robotarium/GRITSBotX_hardware_design/chassisDesign/GritsbotX_1_8.pdf

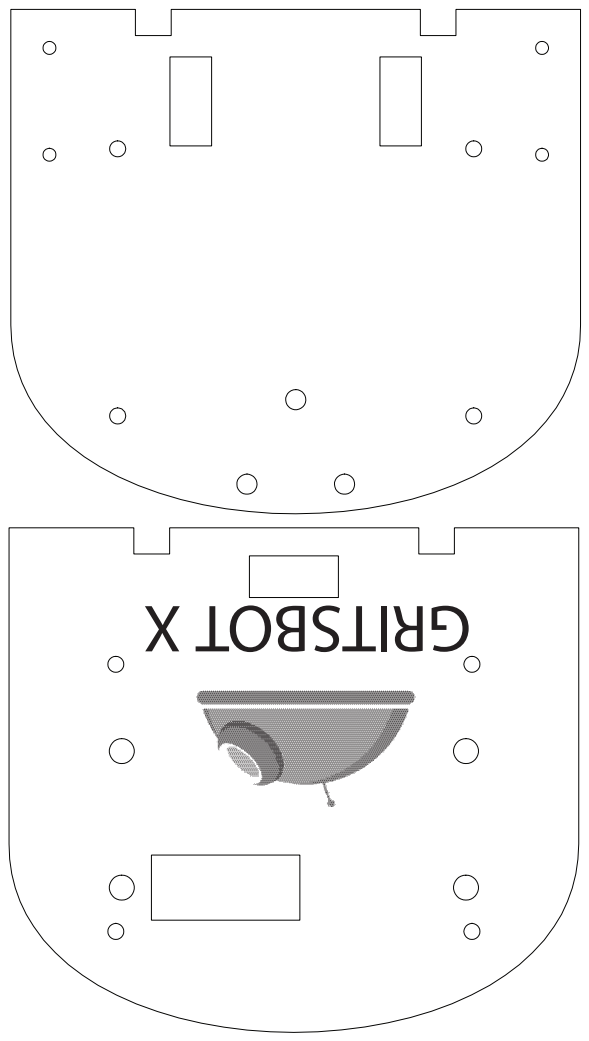
[picture p1: page 1]
GRITSBOT X
