robotarium/GRITSBotX_hardware_design/circuitBoard/GRITSBotX_Full/mainBoard.brd

## EAGLE design circuitBoard/GRITSBotX_Full/mainBoard.brd (2020-12-18)

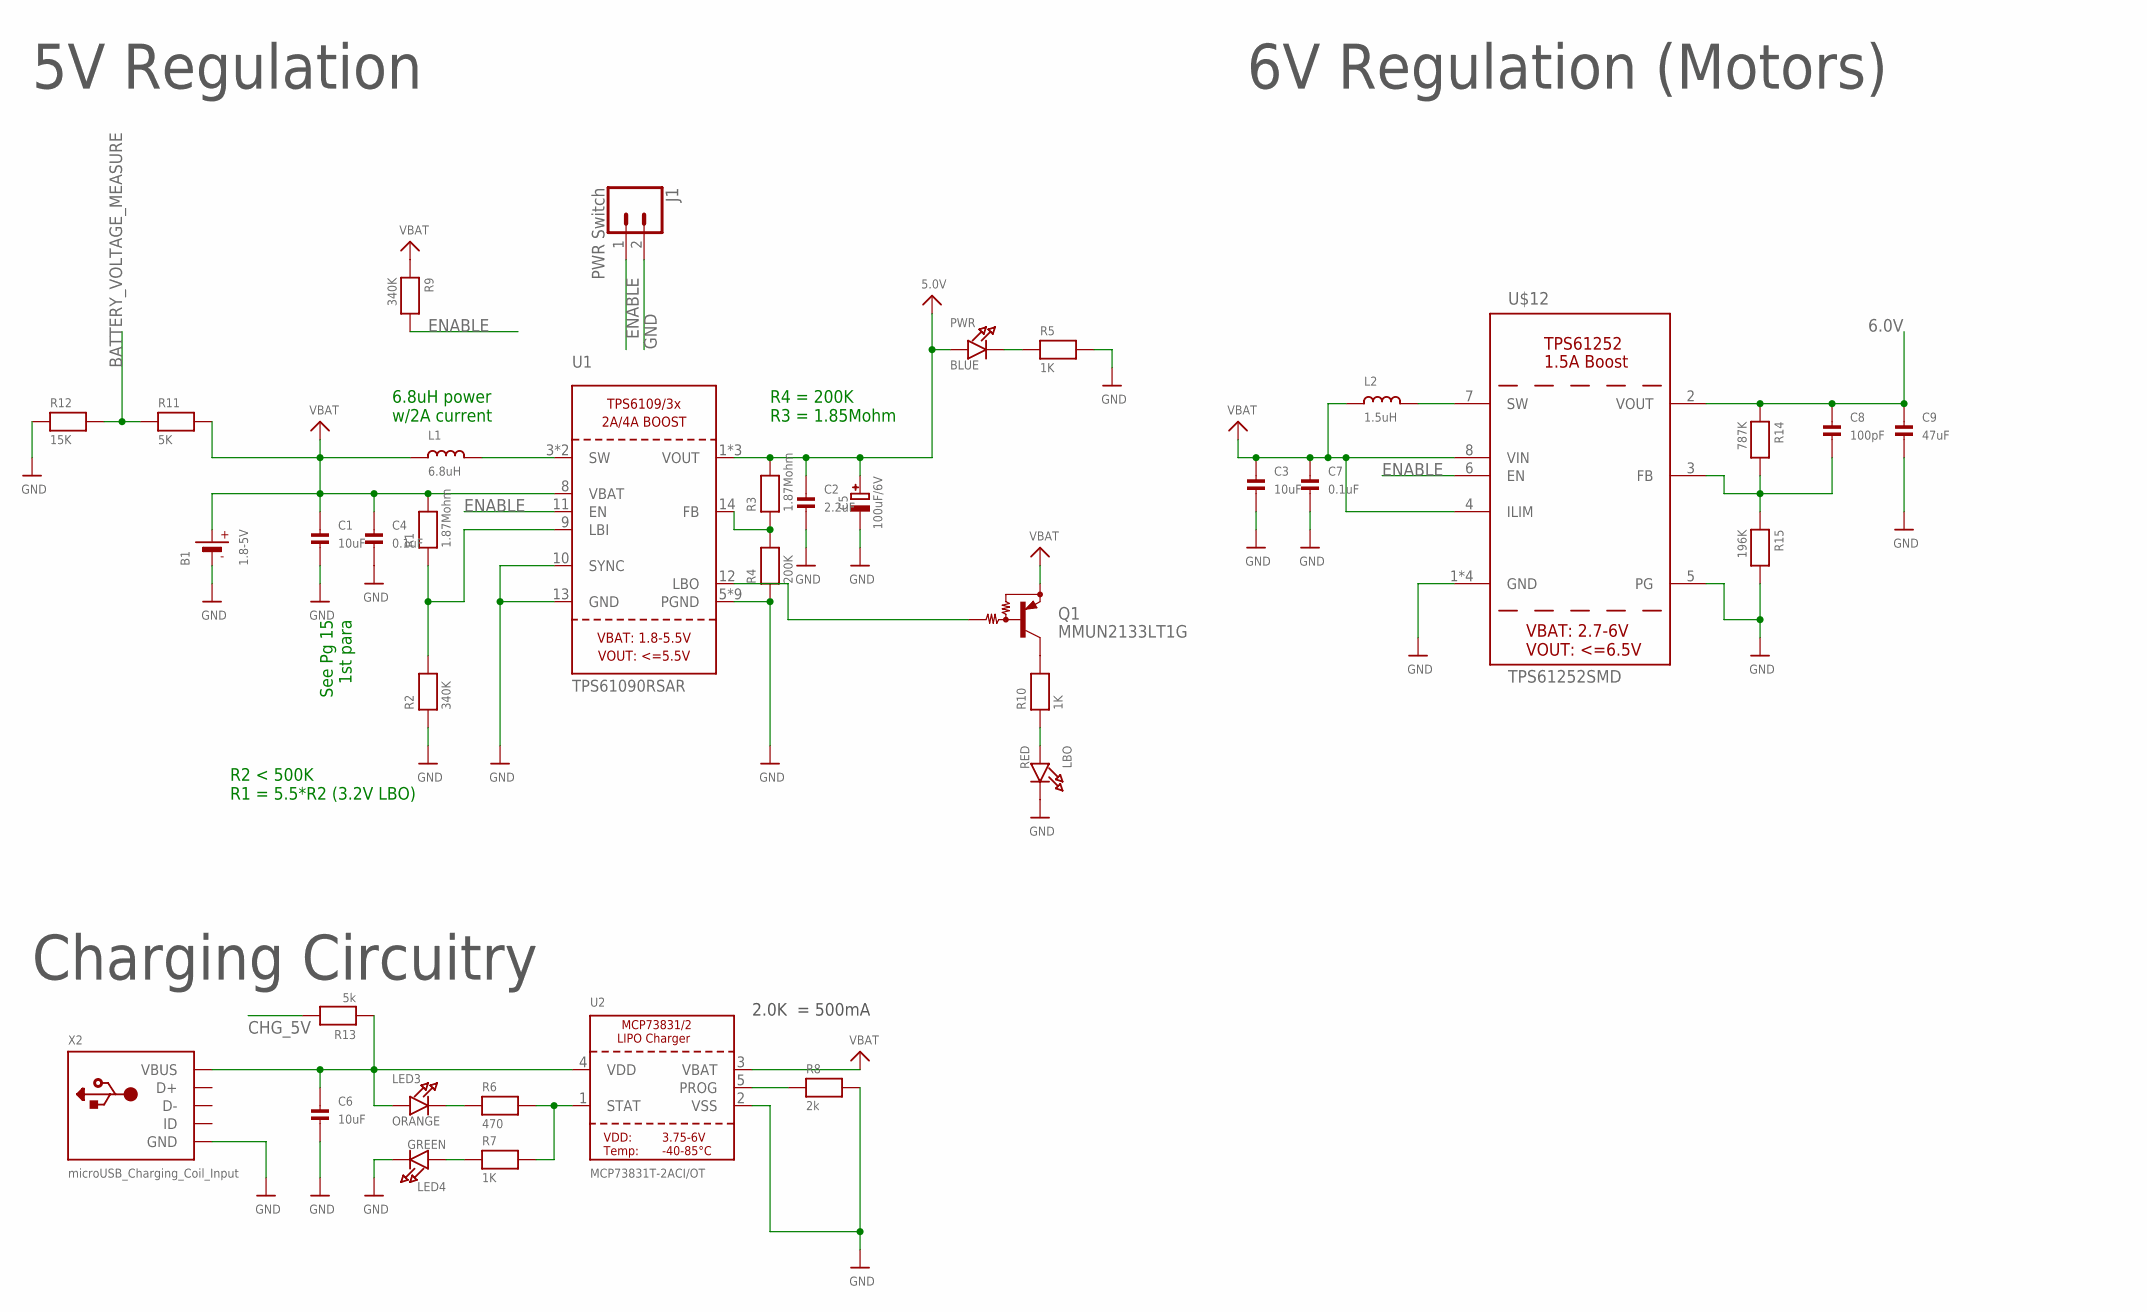
[picture p2: schematic mainBoard.sch, sheet 1]

Parts:
B1: 1.8-5V; JSTPH2
C1, C3, C6: 10uF; 0603
C2: 2.2uF; 0603
C4, C7: 0.1uF; 0805
C5: 100uF/6V; EIA3528-21/B-R
C8: 100pF; 0603
C9: 47uF; 1206
J1: PWR Switch; 1X02
L1: 6.8uH; VISHAY_IHLP2525CZER6R8M01
L2: 1.5uH; MURATA_DFE252012P-1R5M=P2
LBO: RED; CHIPLED_0805_NOOUTLINE
LED3: ORANGE; CHIPLED_0805_NOOUTLINE
LED4: GREEN; CHIPLED_0805_NOOUTLINE
PWR: BLUE; CHIPLED_0805_NOOUTLINE
Q1: MMUN2133LT1G; SC59-BEC
R1, R3: 1.87Mohm; 0805
R2, R9: 340K; 0805
R4: 200K; 0805
R5, R7, R10: 1K; 0805
R6: 470; 0805
R8: 2k; 0805
R11: 5K; 0805
R12: 15K; 0805
R13: 5k; 0805
R14: 787K; 0805
R15: 196K; 0805
U1: TPS61090RSAR; PVQFN-16
U2: MCP73831T-2ACI/OT; SOT23-5
U$12: TPS61252SMD; TPS61252
X2: microUSB_Charging_Coil_Input; 4UCONN_20329

Connections:
5.0V: C2.1, C5.+, PWR.A, R3.2, U1.1 (VOUT), U1.15 (VOUT), U1.16 (VOUT); also elsewhere on the board
6.0V: C8.1, C9.1, R14.1, U$12.2 (VOUT); also elsewhere on the board
BATTERY_VOLTAGE_MEASURE: R11.1, R12.2; also elsewhere on the board
CHARGING_BOOL_5V: C6.1, LED3.A, R13.1, U2.4 (VDD), X2.VBUS
CHG_5V: R13.2; also elsewhere on the board
ENABLE: J1.1, R9.2, U1.11 (EN), U$12.6 (EN)
GND: B1.1 (-), C1.2, C2.2, C3.2, C4.2, C5.-, C6.2, C7.2, C9.2, J1.2, LBO.C, LED4.C, R2.1, R4.1, R5.2, R8.2, R12.1, R15.2, U1.5 (PGND), U1.6 (PGND), U1.7 (PGND), U1.10 (SYNC), U1.13 (GND), U1.P$18 (PGND), U1.P$19 (PGND), U1.P$20 (PGND), U1.P$21 (PGND), U1.P$22 (PGND), U1.THERMAL (PGND), U2.2 (VSS), U$12.1 (GND), U$12.5 (PG), U$12.P$2_GND (GND), U$12.P$3_GND (GND), U$12.THERMAL_GND (GND), X2.BASE@1 (GND), X2.BASE@2 (GND), X2.GND, X2.SPRT@1 (GND), X2.SPRT@2 (GND), X2.SPRT@3 (GND), X2.SPRT@4 (GND); also elsewhere on the board
LBO: Q1.B, U1.12 (LBO)
unnamed: L1.P$2 (2), U1.3 (SW), U1.4 (SW)
unnamed: LBO.A, R10.1
unnamed: R1.1, R2.2, U1.9 (LBI)
unnamed: PWR.C, R5.1
unnamed: R3.1, R4.2, U1.14 (FB)
unnamed: LED3.C, R6.1
unnamed: R6.2, R7.2, U2.1 (STAT)
unnamed: R8.1, U2.5 (PROG)
unnamed: LED4.A, R7.1
unnamed: Q1.C, R10.2
unnamed: L2.P$2 (2), U$12.7 (SW)
unnamed: C8.2, R14.2, R15.1, U$12.3 (FB)
VBAT: B1.2 (+), C1.1, C3.1, C4.1, C7.1, L1.P$1 (1), L2.P$1 (1), Q1.E, R1.2, R9.1, R11.2, U1.8 (VBAT), U2.3 (VBAT), U$12.4 (ILIM), U$12.8 (VIN)

Notes on the sheet:
See Pg 15 1st para
6.8uH power w/2A current
R2 < 500K R1 = 5.5*R2 (3.2V LBO)
R4 = 200K R3 = 1.85Mohm
2.0K = 500mA
Charging Circuitry
5V Regulation
6V Regulation (Motors)

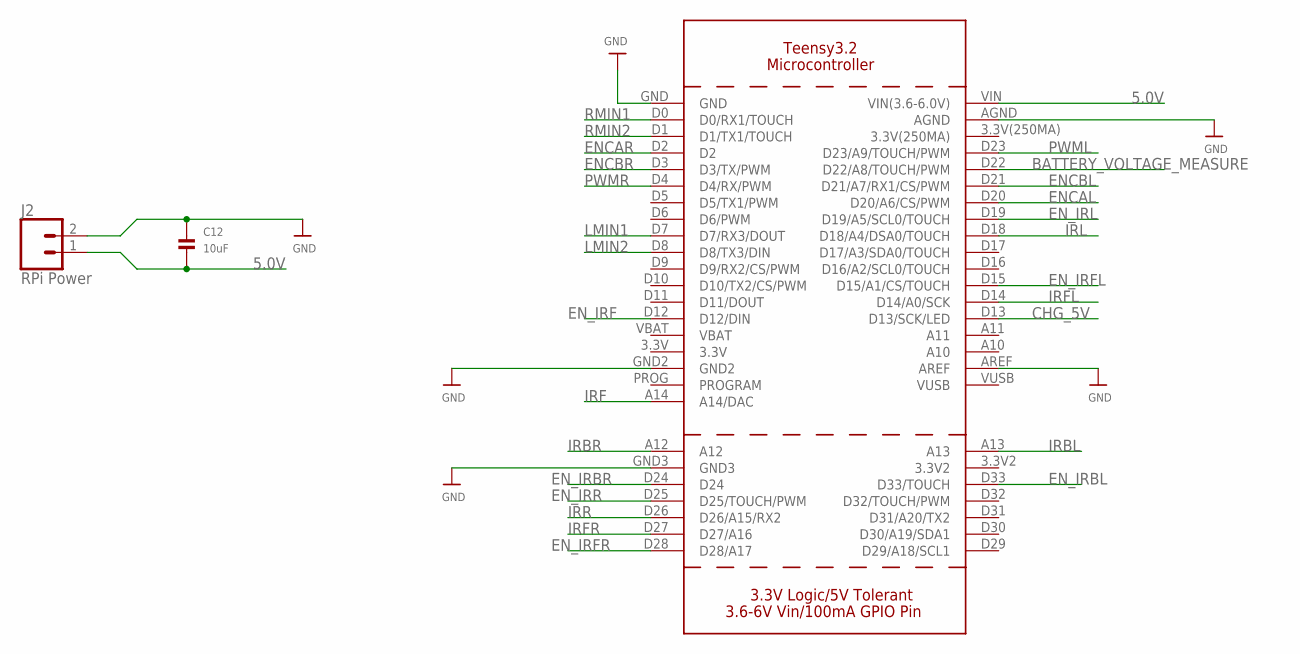
[picture p3: schematic mainBoard.sch, sheet 2]

Parts:
C12: 10uF; 0603
J2: RPi Power; 1X02
U$28: TEENSY3_2

Connections:
5.0V: C12.2, J2.1, U$28.VIN (VIN(3.6-6.0V)); also elsewhere on the board
BATTERY_VOLTAGE_MEASURE: U$28.D22 (D22/A8/TOUCH/PWM); also elsewhere on the board
CHG_5V: U$28.D13 (D13/SCK/LED); also elsewhere on the board
ENCAL: U$28.D20 (D20/A6/CS/PWM); also elsewhere on the board
ENCAR: U$28.D2; also elsewhere on the board
ENCBL: U$28.D21 (D21/A7/RX1/CS/PWM); also elsewhere on the board
ENCBR: U$28.D3 (D3/TX/PWM); also elsewhere on the board
EN_IRBL: U$28.D33 (D33/TOUCH); also elsewhere on the board
EN_IRBR: U$28.D24; also elsewhere on the board
EN_IRF: U$28.D12 (D12/DIN); also elsewhere on the board
EN_IRFL: U$28.D15 (D15/A1/CS/TOUCH); also elsewhere on the board
EN_IRFR: U$28.D28 (D28/A17); also elsewhere on the board
EN_IRL: U$28.D19 (D19/A5/SCL0/TOUCH); also elsewhere on the board
EN_IRR: U$28.D25 (D25/TOUCH/PWM); also elsewhere on the board
GND: C12.1, J2.2, U$28.AGND, U$28.AREF, U$28.GND, U$28.GND2, U$28.GND3; also elsewhere on the board
IRBL: U$28.A13; also elsewhere on the board
IRBR: U$28.A12; also elsewhere on the board
IRF: U$28.A14 (A14/DAC); also elsewhere on the board
IRFL: U$28.D14 (D14/A0/SCK); also elsewhere on the board
IRFR: U$28.D27 (D27/A16); also elsewhere on the board
IRL: U$28.D18 (D18/A4/DSA0/TOUCH); also elsewhere on the board
IRR: U$28.D26 (D26/A15/RX2); also elsewhere on the board
LMIN1: U$28.D7 (D7/RX3/DOUT); also elsewhere on the board
LMIN2: U$28.D8 (D8/TX3/DIN); also elsewhere on the board
PWML: U$28.D23 (D23/A9/TOUCH/PWM); also elsewhere on the board
PWMR: U$28.D4 (D4/RX/PWM); also elsewhere on the board
RMIN1: U$28.D0 (D0/RX1/TOUCH); also elsewhere on the board
RMIN2: U$28.D1 (D1/TX1/TOUCH); also elsewhere on the board

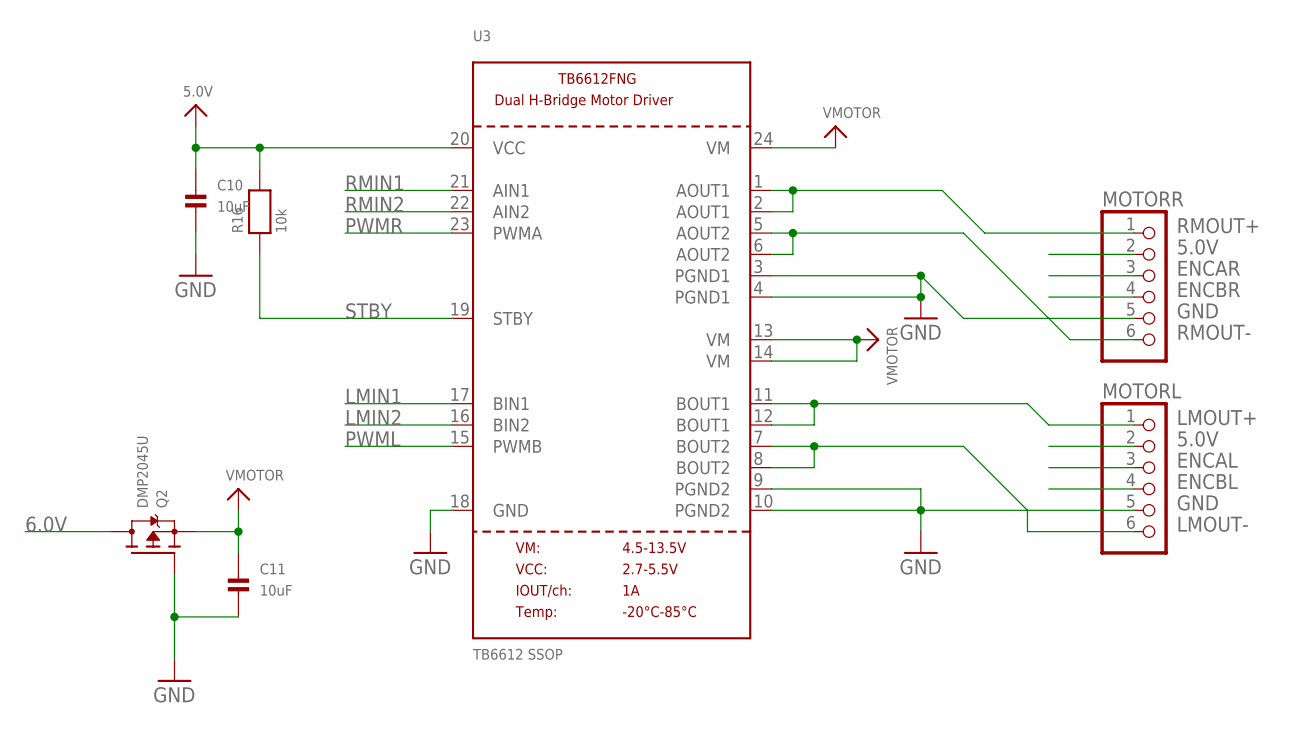
[picture p4: schematic mainBoard.sch, sheet 3]

Parts:
C10, C11: 10uF; 0603
MOTORL: PINHD-1X6CB; 1X06-CLEANBIG
MOTORR: PINHD-1X6CB; 1X06-CLEANBIG
Q2: DMP2045U; SOT23-WIDE
R16: 10k; 0805
U3: TB6612 SSOP; SSOP24

Connections:
5.0V: C10.1, MOTORL.2, MOTORR.2, R16.2, U3.20 (VCC); also elsewhere on the board
6.0V: Q2.3 (D); also elsewhere on the board
ENCAL: MOTORL.3; also elsewhere on the board
ENCAR: MOTORR.3; also elsewhere on the board
ENCBL: MOTORL.4; also elsewhere on the board
ENCBR: MOTORR.4; also elsewhere on the board
GND: C10.2, C11.2, MOTORL.5, MOTORR.5, Q2.1 (G), U3.3 (PGND1), U3.4 (PGND1), U3.9 (PGND2), U3.10 (PGND2), U3.18 (GND); also elsewhere on the board
LMIN1: U3.17 (BIN1); also elsewhere on the board
LMIN2: U3.16 (BIN2); also elsewhere on the board
LMOUT+: MOTORL.1, U3.11 (BOUT1), U3.12 (BOUT1)
LMOUT-: MOTORL.6, U3.7 (BOUT2), U3.8 (BOUT2)
PWML: U3.15 (PWMB); also elsewhere on the board
PWMR: U3.23 (PWMA); also elsewhere on the board
RMIN1: U3.21 (AIN1); also elsewhere on the board
RMIN2: U3.22 (AIN2); also elsewhere on the board
RMOUT+: MOTORR.1, U3.1 (AOUT1), U3.2 (AOUT1)
RMOUT-: MOTORR.6, U3.5 (AOUT2), U3.6 (AOUT2)
STBY: R16.1, U3.19 (STBY)
VMOTOR: C11.1, Q2.2 (S), U3.13 (VM), U3.14 (VM), U3.24 (VM)

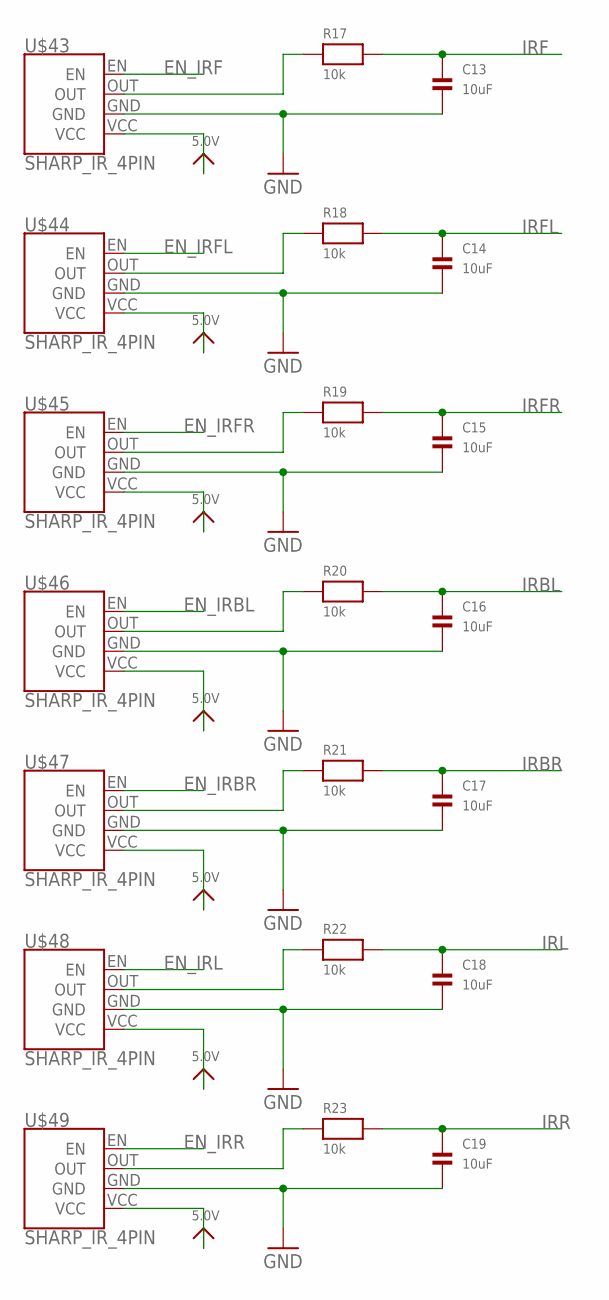
[picture p5: schematic mainBoard.sch, sheet 4]

Parts:
C13, C14, C15, C16, C17, C18, C19: 10uF; 0603
R17, R18, R19, R20, R21, R22, R23: 10k; 0805
U$43, U$44, U$45, U$46, U$47, U$48, U$49: SHARP_IR_4PIN

Connections:
5.0V: U$43.VCC, U$44.VCC, U$45.VCC, U$46.VCC, U$47.VCC, U$48.VCC, U$49.VCC; also elsewhere on the board
EN_IRBL: U$46.EN; also elsewhere on the board
EN_IRBR: U$47.EN; also elsewhere on the board
EN_IRF: U$43.EN; also elsewhere on the board
EN_IRFL: U$44.EN; also elsewhere on the board
EN_IRFR: U$45.EN; also elsewhere on the board
EN_IRL: U$48.EN; also elsewhere on the board
EN_IRR: U$49.EN; also elsewhere on the board
GND: C13.2, C14.2, C15.2, C16.2, C17.2, C18.2, C19.2, U$43.GND, U$44.GND, U$45.GND, U$46.GND, U$47.GND, U$48.GND, U$49.GND; also elsewhere on the board
IRBL: C16.1, R20.2; also elsewhere on the board
IRBR: C17.1, R21.2; also elsewhere on the board
IRF: C13.1, R17.2; also elsewhere on the board
IRFL: C14.1, R18.2; also elsewhere on the board
IRFR: C15.1, R19.2; also elsewhere on the board
IRL: C18.1, R22.2; also elsewhere on the board
IRR: C19.1, R23.2; also elsewhere on the board
unnamed: R23.1, U$49.OUT
unnamed: R22.1, U$48.OUT
unnamed: R21.1, U$47.OUT
unnamed: R20.1, U$46.OUT
unnamed: R19.1, U$45.OUT
unnamed: R18.1, U$44.OUT
unnamed: R17.1, U$43.OUT

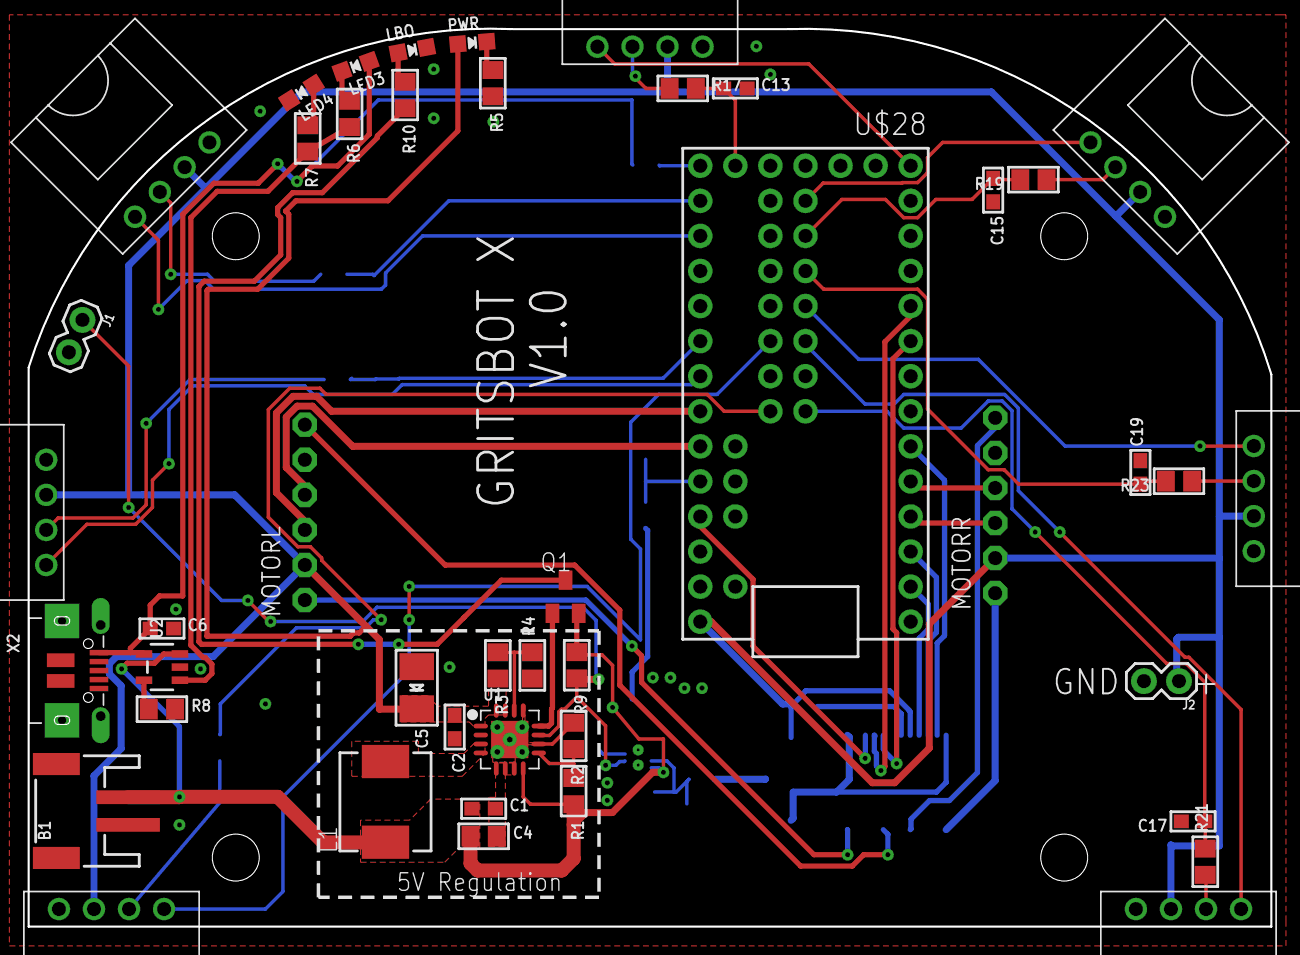
[picture p6: board mainBoard.brd from above]

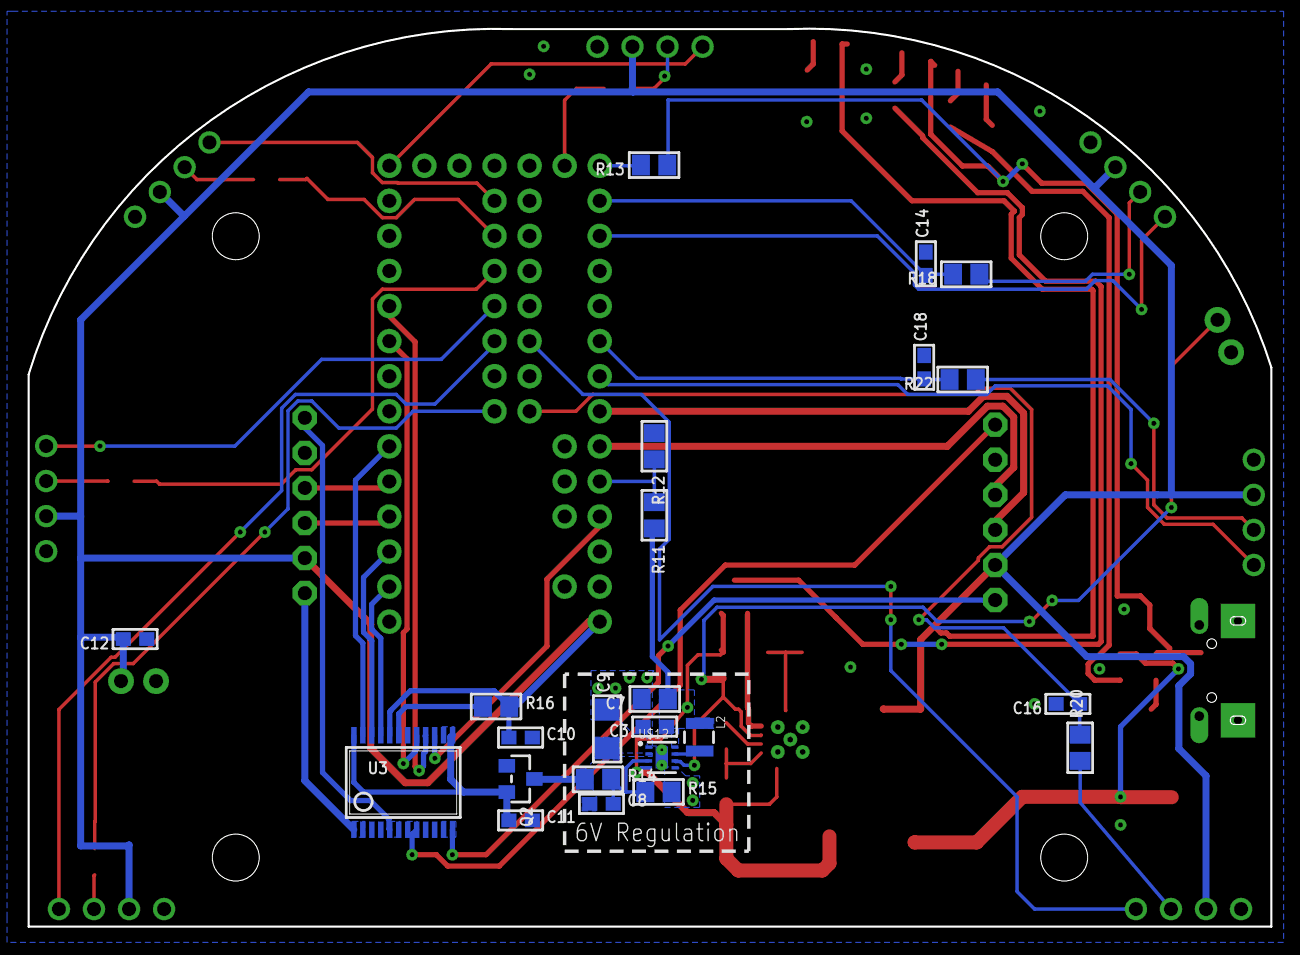
[picture p7: board mainBoard.brd from below]

Board: 2 copper layers, 90.0 x 65.0 mm, 72 parts (23 on the bottom side), 58 nets.

Other parts of the board:
U$1, U$2, U$3, U$4: M3_SCREW
