robotarium/GRITSBotX_hardware_design/circuitBoard/componentDesigns/Adafruit-TB6612-Motor-Driver-Breakout-PCB-master/Adafruit TB6612.brd

## EAGLE design circuitBoard/componentDesigns/Adafruit-TB6612-Motor-Driver-Breakout-PCB-master/Adafruit TB6612.brd (2020-12-18)


Parts:
C2, C3: 10µF; 0805-NO
FID1, FID2: FIDUCIAL""; FIDUCIAL_1MM
J1: VMOTORIN; TERMBLOCK_1X2-3.5MM
JP1: HEADER-1X10THICKER; 1X10_ROUND_76
JP3: PINHD-1X6CB; 1X06-CLEANBIG
Q1: DMG3415; SOT23-WIDE
R1: 10K; 0805-NO
U1: TB6612 SSOP; SSOP24
U$13, U$14: MOUNTINGHOLE2.5; MOUNTINGHOLE_2.5_PLATED

Connections:
AIN1: JP1.8, U1.21 (AIN1)
AIN2: JP1.9, U1.22 (AIN2)
BIN1: JP1.6, U1.17 (BIN1)
BIN2: JP1.5, U1.16 (BIN2)
GND: C2.2, C3.2, J1.2, JP1.3, JP3.3, JP3.4, Q1.1 (G), U1.3 (PGND1), U1.4 (PGND1), U1.9 (PGND2), U1.10 (PGND2), U1.18 (GND)
MA1: JP3.1, U1.1 (AOUT1), U1.2 (AOUT1)
MA2: JP3.2, U1.5 (AOUT2), U1.6 (AOUT2)
MB1: JP3.6, U1.11 (BOUT1), U1.12 (BOUT1)
MB2: JP3.5, U1.7 (BOUT2), U1.8 (BOUT2)
PWMA: JP1.10, U1.23 (PWMA)
PWMB: JP1.4, U1.15 (PWMB)
PWRIN: J1.1, JP1.1, Q1.3 (D)
STBY: JP1.7, R1.1, U1.19 (STBY)
VCC: C2.1, JP1.2, R1.2, U1.20 (VCC)
VMOTOR: C3.1, Q1.2 (S), U1.13 (VM), U1.14 (VM), U1.24 (VM)


Board: 2 copper layers, 19.1 x 26.7 mm, 14 parts (1 on the bottom side), 15 nets.

Other parts of the board:
U$11: ADAFRUIT_3.5MM
U$15: ADAFRUIT_5MM
